kaievns/little-wing/README.md

# Little Wing Keyboard

This my attempt to build a better keyboard for myself.

Think of it as a 32% split bluetooth keyboard merged with the classic MX Ergo trackball

## License

Little Wing Keyboard © 2024 by Kai Evans is licensed under CC BY-SA 4.0
