kaievns/little-wing/kicad/mobo/mobo.kicad_pcb

## KiCad design kicad/mobo/mobo.kicad_pcb (2025-03-29)

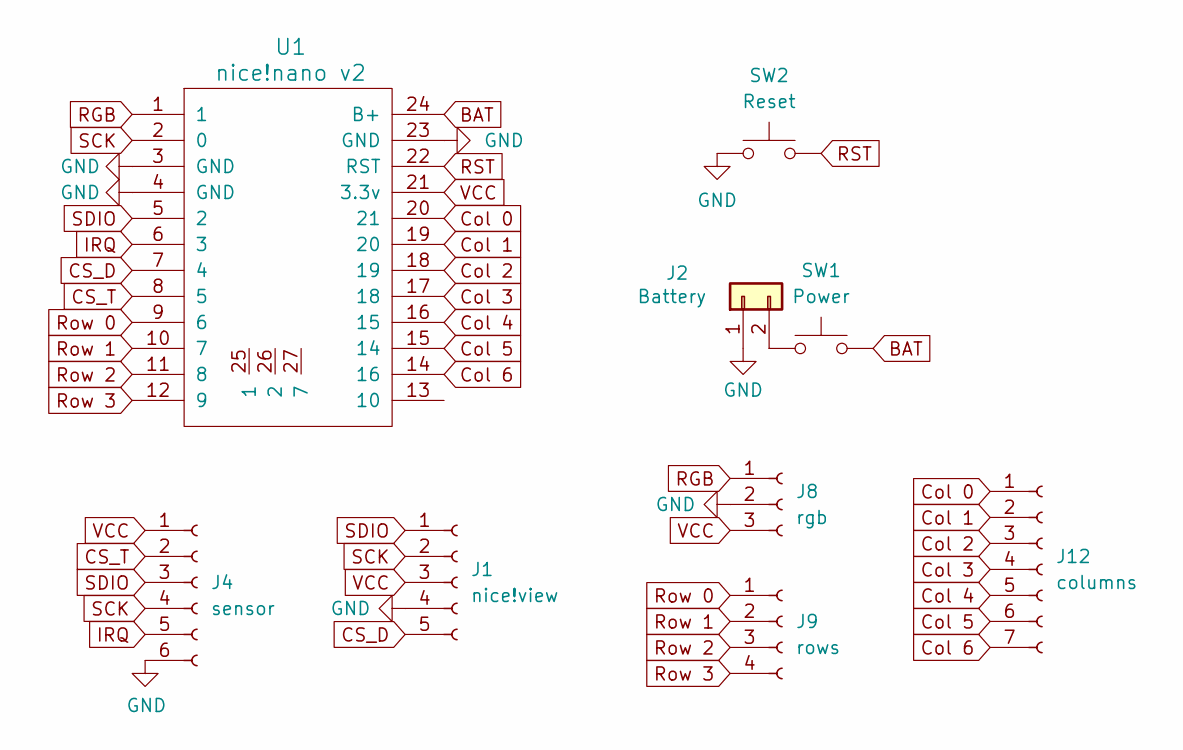
[picture p1: schematic mobo.kicad_sch]

Parts:
J1: nice!view; PinHeader_1x05_P2.54mm_Vertical
J2: Battery; JST_ZH_S2B-ZR-SM4A-TF_1x02-1MP_P1.50mm_Horizontal
J4: sensor; Wuerth_WR-WTB_64800611622_1x06_P1.50mm_Vertical
J8: rgb; Wuerth_WR-WTB_64800311622_1x03_P1.50mm_Vertical
J9: rows; Wuerth_WR-WTB_64800411622_1x04_P1.50mm_Vertical
J12: columns; Wuerth_WR-WTB_64800711622_1x07_P1.50mm_Vertical
SW1: Power; SW_SPDT_PCM12
SW2: Reset; SW_SPST_B3U-1000P
U1: nice!nano v2; Nice_Nano_V2_Flipped

Connections:
BAT: SW1.2, U1.24 (B+)
CS_D: J1.5, U1.7 (4)
CS_T: J4.2, U1.8 (5)
Col 0: J12.1, U1.20 (21)
Col 1: J12.2, U1.19 (20)
Col 2: J12.3, U1.18 (19)
Col 3: J12.4, U1.17 (18)
Col 4: J12.5, U1.16 (15)
Col 5: J12.6, U1.15 (14)
Col 6: J12.7, U1.14 (16)
GND: J1.4, J2.1, J4.6, J8.2, SW2.1, U1.3 (GND), U1.4 (GND), U1.23 (GND)
IRQ: J4.5, U1.6 (3)
unnamed: J2.2, SW1.1
RGB: J8.1, U1.1
RST: SW2.2, U1.22 (RST)
Row 0: J9.1, U1.9 (6)
Row 1: J9.2, U1.10 (7)
Row 2: J9.3, U1.11 (8)
Row 3: J9.4, U1.12 (9)
SCK: J1.2, J4.4, U1.2 (0)
SDIO: J1.1, J4.3, U1.5 (2)
VCC: J1.3, J4.1, J8.3, U1.21 (3.3v)

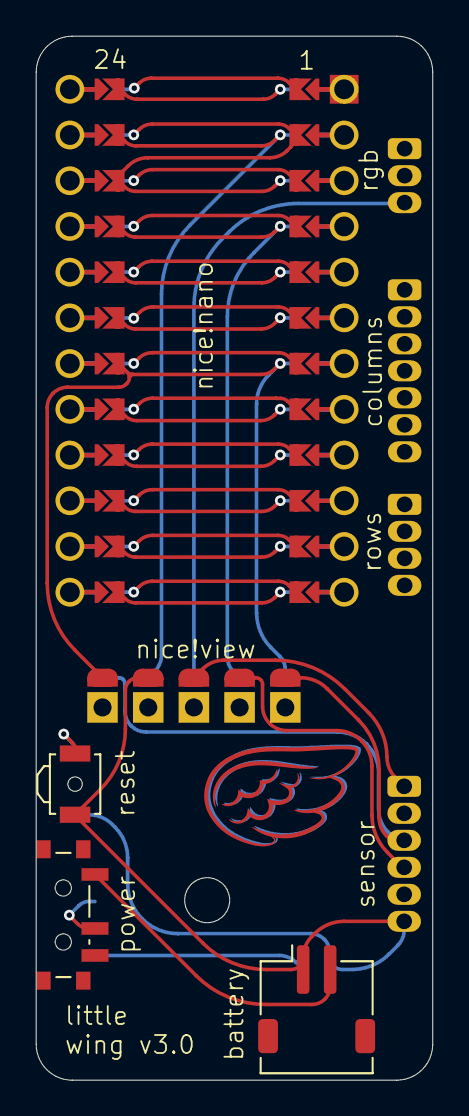
[picture p2: board mobo.kicad_pcb from above]

Board: 4 copper layers, 22.0 x 58.0 mm, 9 parts (0 on the bottom side), 22 nets.
