kaievns/little-wing/kicad/sensor/sensor.kicad_pcb

## KiCad design kicad/sensor/sensor.kicad_pcb (2025-05-03)

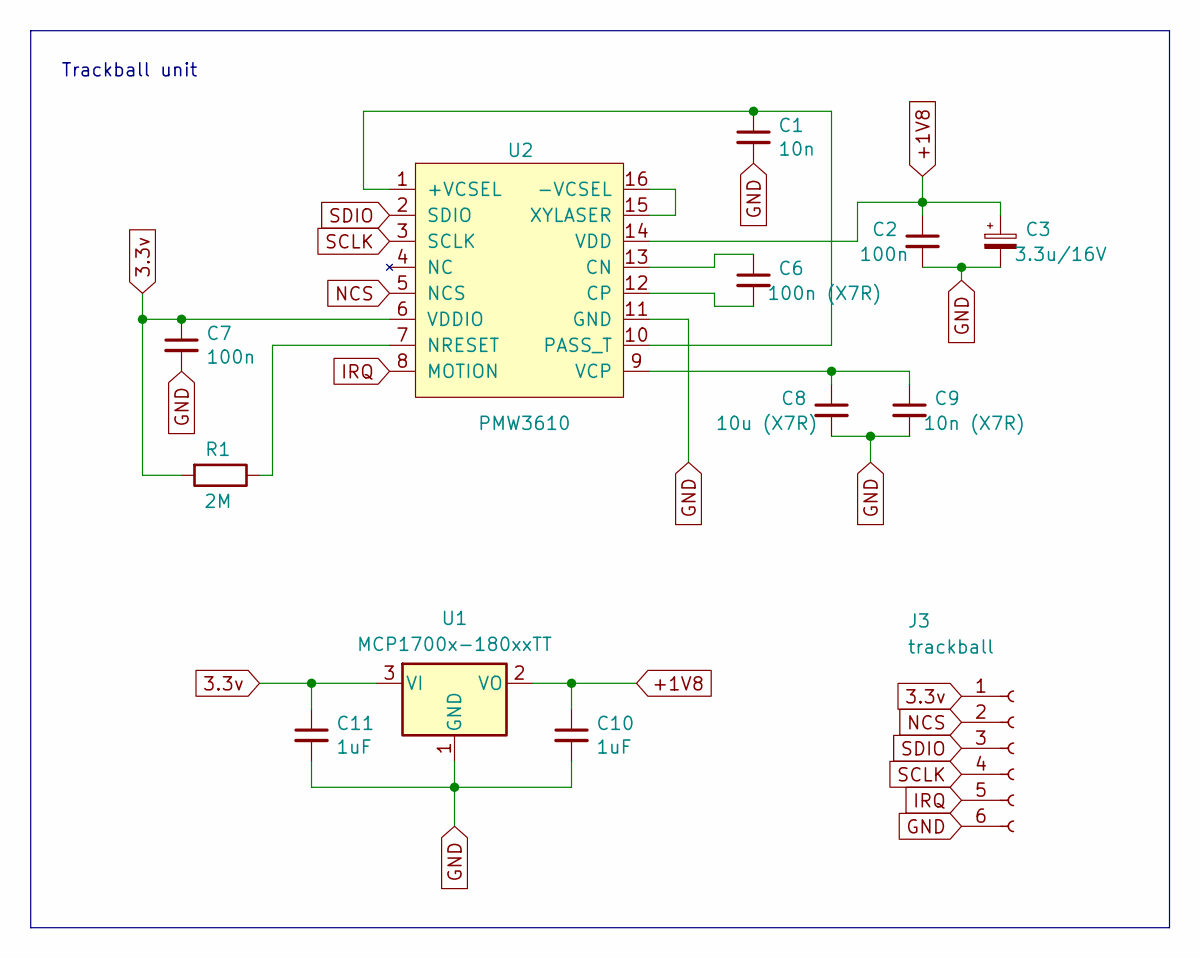
[picture p3: schematic sensor.kicad_sch]

Parts:
C1: 10n; C_0603_1608Metric; LCSC C19666
C2, C7: 100n; C_0603_1608Metric; LCSC C19666
C3: 3.3u/16V; C_0603_1608Metric; LCSC C19666
C6: 100n (X7R); C_0603_1608Metric; LCSC C19666
C8: 10u (X7R); C_0603_1608Metric; LCSC C19666
C9: 10n (X7R); C_0603_1608Metric; LCSC C19666
C10, C11: 1uF; C_0603_1608Metric; LCSC C15849
J3: trackball; Wuerth_WR-WTB_64800611622_1x06_P1.50mm_Vertical
R1: 2M; R_0603_1608Metric
U1: MCP1700x-180xxTT; SOT-23
U2: PMW3610

Connections:
3.3v: C7.1, C11.1, J3.1, R1.2, U1.3 (VI), U2.6 (VDDIO)
+1V8: C2.1, C3.1, C10.1, U1.2 (VO), U2.14 (VDD)
GND: C1.2, C2.2, C3.2, C7.2, C8.2, C9.2, C10.2, C11.2, J3.6, U1.1 (GND), U2.11 (GND)
IRQ: J3.5, U2.8 (MOTION)
NCS: J3.2, U2.5 (NCS)
unnamed: C1.1, U2.1 (+VCSEL), U2.10 (PASS_T)
unnamed: U2.15 (XYLASER), U2.16 (-VCSEL)
unnamed: C6.1, U2.13 (CN)
unnamed: C6.2, U2.12 (CP)
unnamed: R1.1, U2.7 (NRESET)
unnamed: C8.1, C9.1, U2.9 (VCP)
SCLK: J3.4, U2.3 (SCLK)
SDIO: J3.3, U2.2 (SDIO)

Notes on the sheet:
Trackball unit

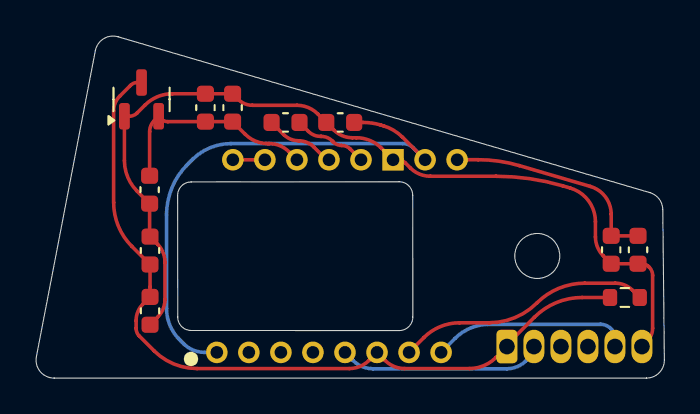
[picture p4: board sensor.kicad_pcb from above]

Board: 4 copper layers, 34.9 x 19.0 mm, 13 parts (0 on the bottom side), 13 nets.
