kaievns/little-wing/(commit log)

2024-08-05 Initial setup
    [little-wing.kicad_pcb, little-wing.kicad_sch]
2024-08-07 Initial PCB layout
    [little-wing.kicad_pcb, little-wing.kicad_sch]
2024-08-07 Flipping the components in place
    [little-wing.kicad_pcb, little-wing.kicad_sch]
2024-08-08 Remaking the PCB for better alignment
    [little-wing.kicad_pcb, little-wing.kicad_sch]
2024-08-09 Stashing the work before extending the cutouts
    [little-wing.kicad_pcb]
2024-08-10 Making a column work
    [little-wing.kicad_pcb, little-wing.kicad_sch]
2024-08-10 Sorting out the main reversible pads
    [little-wing.kicad_pcb]
2024-08-11 Connecting the reversible pads together
    [little-wing.kicad_pcb]
2024-08-11 Saving the main lanes progress
    [little-wing.kicad_pcb, little-wing.kicad_sch]
2024-08-13 Linking all the main columns together
    [little-wing.kicad_pcb]
2024-08-13 Initial alignment of the sensor block
    [little-wing.kicad_pcb, little-wing.kicad_sch]
2024-08-13 Wiring togother the sensor board
    [little-wing.kicad_pcb]
2024-08-14 Rounding out the main columns cutouts
    [little-wing.kicad_pcb, little-wing.kicad_sch]
2024-08-14 Refactoring the main junction a bit
    [little-wing.kicad_pcb]
2024-08-15 Initial MCU wiring
    [little-wing.kicad_pcb, little-wing.kicad_sch]
2024-08-16 Wiring up the MCU block
    [little-wing.kicad_pcb, little-wing.kicad_sch]
2024-08-17 Finalizing the wiring
    [little-wing.kicad_pcb]
2024-08-17 Repairing the cutouts and adding the flex markings
    [little-wing.kicad_pcb]
2024-08-17 Clearing out all the wiring
    [little-wing.kicad_pcb]
2024-08-18 Rewiring one column in the 4 stack configuration
    [little-wing.kicad_pcb]
2024-08-18 Wiring up all the main column pads
    [little-wing.kicad_pcb]
2024-08-18 Wiring up the main columns
    [little-wing.kicad_pcb]
2024-08-18 The first pass wiring together the columns
    [little-wing.kicad_pcb]
2024-08-18 Completing the columns wiring
    [little-wing.kicad_pcb]
2024-08-18 Cleaning up the columns wiring
    [little-wing.kicad_pcb]
2024-08-18 Cleaning up the main columns exit wiring
    [little-wing.kicad_pcb]
2024-08-18 Attaching the columns to MCU
    [little-wing.kicad_pcb, little-wing.kicad_sch]
2024-08-20 Wiring together the thumbs cluster
    [little-wing.kicad_pcb, little-wing.kicad_sch]
2024-08-20 Re-aligning a few things to make the ribbons more flexible and avoid cross talk
    [little-wing.kicad_pcb]
2024-08-20 Spit and polish
    [little-wing.kicad_pcb]
2024-08-25 Adding the left/right hand split
    [little-wing.kicad_sch]
2024-08-25 Syncing the schematics and pcb
    [little-wing.kicad_pcb, little-wing.kicad_sch]
2024-08-25 Setting up the new grid outline
    [little-wing.kicad_pcb]
2024-08-26 Creating the reusable key pad
    [little-wing.kicad_pcb, little-wing.kicad_sch]
2024-08-27 Lining up some extra sockets for wiring
    [little-wing.kicad_pcb, little-wing.kicad_sch]
2024-08-27 Lining up the cable wiring points
    [little-wing.kicad_pcb]
2024-08-28 Lining up the main board components
    [little-wing.kicad_pcb]
2024-08-28 Wiring together the mobos
    [little-wing.kicad_pcb, little-wing.kicad_sch]
2024-08-29 Sorting out silk screens
    [little-wing.kicad_pcb]
2024-08-29 Final touches for the mobos
    [little-wing.kicad_pcb]
2024-08-29 Rewiring the trackball sensor PCB
    [little-wing.kicad_pcb]
2024-08-29 Some more clean up
    [little-wing.kicad_pcb]
2024-09-17 Swapping out some components
    [little-wing.kicad_pcb]
2024-09-17 Reconnecting all the components on PCB again
    [little-wing.kicad_pcb]
2024-09-17 Rearranging things a bit
    [little-wing.kicad_pcb]
2024-09-17 Realigning the panel elements
    [little-wing.kicad_pcb]
2024-09-17 Adding the mouse bites
    [little-wing.kicad_pcb]
2024-09-18 Adding the breakaway arks
    [little-wing.kicad_pcb]
2024-09-18 Stitching all the sub-pcbs into a panel
    [little-wing.kicad_pcb]
2024-09-18 Adding manufacturing panels
    [little-wing.kicad_pcb]
2024-10-05 Moving all the kicads into its own folder
    [little-wing.kicad_pcb, little-wing.kicad_sch]
2024-10-14 Stashig the work
    [little-wing.kicad_sch]
2024-10-17 Making the sensor somewhat working
2024-10-23 Making different drivers compile again
2025-01-04 Reworking the schematics for a smaller power stepdown unit
    [little-wing.kicad_pcb, little-wing.kicad_sch]
2025-01-04 Updating the pmw3610 driver
2025-01-05 Patching the display select pin
2025-01-11 Throwing in the new PCB outline for the optical sensor
    [little-wing.kicad_pcb]
2025-01-12 Stashing work
    [little-wing.kicad_pcb]
2025-01-18 Splitting the KiCAD project into thre independent PCBs
    [keypad.kicad_pcb, keypad.kicad_sch, little-wing.kicad_pcb, little-wing.kicad_sch, mobo.kicad_pcb, mobo.kicad_sch, sensor.kicad_pcb, sensor.kicad_sch]
2025-01-18 Reworking the sensor PCB
    [sensor.kicad_pcb, sensor.kicad_sch]
2025-03-28 Resetting the mobo stack to 4 layers mirrorable
    [mobo.kicad_pcb, mobo.kicad_sch, sensor.kicad_sch]
2025-03-29 Reworking the mobo into a reversible panel
    [mobo.kicad_pcb]
2025-03-29 Reworking the keypad PCB
    [keypad.kicad_pcb, keypad.kicad_sch, mobo.kicad_pcb]
2025-03-29 Releasing all the gerbers
    [keypad.kicad_pcb_bom.csv, keypad.kicad_pcb_positions.csv, mobo.kicad_pcb_bom.csv, mobo.kicad_pcb_positions.csv, sensor.kicad_pcb, sensor.kicad_pcb_bom.csv, sensor.kicad_pcb_positions.csv]
2025-05-03 Stashing pcb changes
    [keypad.kicad_pcb, sensor.kicad_pcb]
2025-05-03 Patching some of the wiring
2025-05-04 Upgrading the optical driver to support multi-device SPIs
2025-09-24 Stashing the work
    [keypad.kicad_pcb, keypad.kicad_sch, mobo.kicad_pcb, mobo.kicad_sch, sensor.kicad_pcb, sensor.kicad_sch, tiny-wing.kicad_pcb, tiny-wing.kicad_sch]
2025-09-24 Stashing driver changes
